scheidtdav/vibration-sensor-shot-timer/(commit log)

2026-10-04 Add ESP32-C3 shot timer firmware, wiring docs, and OpenSCAD case
    - Vibration-sensed shot timer (SW-420) for Plus Aroma ESE pad machine
    - SSD1306 OLED timer with good-shot band and shot counter
    - PlatformIO config for esp32-c3-devkitm-1
    - Parametric 3D-printable display pod case
    [shot-timer-case.scad]
2026-10-12 Fix vibration sensor polarity: SW-420 element is normally closed
    The SW-420's vibration element is normally closed: the module's DO idles
    LOW at rest and pulses HIGH during vibration. The firmware previously
    assumed the opposite (DO idles HIGH, pulses LOW), causing constant
    triggering on the real hardware.
    - Treat VIBRATION_ACTIVE_LEVEL (default HIGH) as the pulse polarity,
    configurable in one place for inverted-output clone modules
    - Input pull mode now follows the active level (pulldown for HIGH-active)
    - Update README detection notes and troubleshooting accordingly
    [main.cpp]
2026-10-12 Redesign idle screen: centered layout with drawn espresso cup icon
    - Replace 'AROMA'/'SHOT TIMER' text stack with a pixel-drawn espresso
    cup (tapered body, crema line, handle ring, saucer) in the upper half
    - 'SHOT TIMER' label centered beneath the cup
    - Pure primitive drawing (triangles/circles/lines), no bitmap data
    [main.cpp]
2026-10-12 Increase IDLE screen 'SHOT TIMER' label to size 2
2026-10-12 Fix missing 'frac' declaration in renderRunning progress bar
    The bar rewrite dropped the frac computation (elapsed/GOOD_MAX, clamped
    to 1.0) that the fill width depends on. Restore it.
    [main.cpp]
2026-10-13 Redesign case (v2): fix floating geometry, magnetic two-part mount
    The v1 model produced disconnected floating pieces (an OLED shelf
    positioned outside the extruded body), an impossible cavity (14mm tall
    for a 27mm PCB), magnet pockets that pierced the back wall, and a
    wrong print-orientation claim. Complete rewrite:
    - One consistent coordinate frame; all front-face features placed via a
    shared on_front() transform along the face normal
    - Cavity resized: 30x36mm fits the 27x27 OLED PCB upright
    - OLED seat plate now spans the full outer width, fusing into the side
    walls (no floating parts), parallel to the window by construction
    - Blind magnet pockets (3.0mm deep in 3.6mm wall) in the po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
    [shot-timer-case.scad]
2026-10-13 Drop backing plate: mount pod magnets directly on steel panels
    The Plus Aroma's panels are steel, so the pod's magnets grip the
    machine directly. Removes the VHB-taped backing plate part, its
    parameters, and all tape references from the docs. Direct mount also
    reduces part count and puts the vibration-coupled back wall flush
    against the machine body.
    [shot-timer-case.scad]
2026-10-13 Clean up stale backing-plate references in case header comment
    [shot-timer-case.scad]
2026-10-13 Document power distribution and component placement
    The ESP32-C3 Super Mini has a single 3V3/GND pin pair, but OLED and
    SW-420 both need power: document the star-at-the-pin solder-bundle
    technique, signal wiring, and the component placement (ESP32 and
    SW-420 glued to the back wall, OLED seated last).
2026-10-13 Recommend perfboard power bus over solder bundles
    Single 3V3/GND pin on the ESP32-C3 Super Mini: recommend a small
    perfboard power bus with header pins and Dupont jumpers (reworkable,
    strain relief, header-pre-soldered consumer modules) and demote the
    twisted-solder-bundle approach to the minimal-parts alternative.
2026-10-13 Deepen case cavity to fit perfboard power bus
    inner_d 16 -> 20mm: the free depth behind the OLED seat plate grows
    from 7.6mm to 11.6mm, enough for the ESP32 (1mm) + perfboard bus
    glued flat (1.6mm) + Dupont jumpers lying on their side (~8mm).
    Verified numerically; assembly notes updated.
    [shot-timer-case.scad]
2026-11-12 Remove case, shorten README, add vibe-coded note
    - Delete case/ (OpenSCAD pod and its docs) entirely
    - README: trim assembly/placement instructions, keep compact power-bus
    note and the wiring diagram, add note that the project was entirely
    vibe coded
    [shot-timer-case.scad]
